Motto6666/Material_Sorting_Pipeline/README.md

# Material_Sorting_Pipeline
Material_Sorting_Pipeline_Code
