Motto6666/Material_Sorting_Pipeline/Program_Flow Chart/OpenMv模块程序流程图.jpg

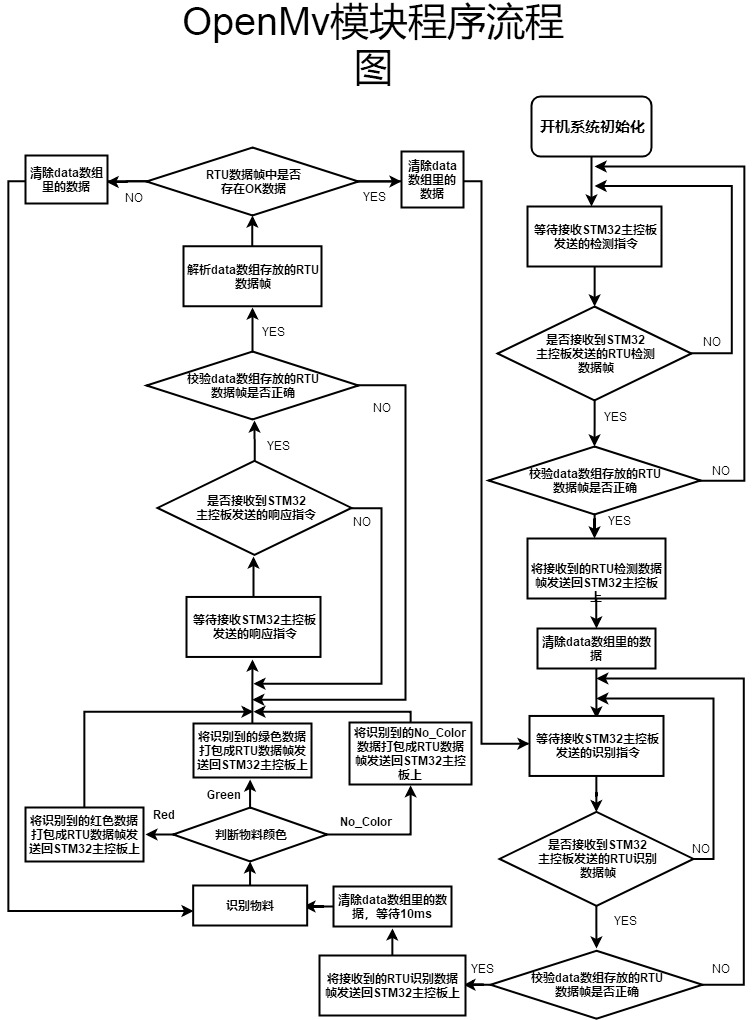
Program_Flow Chart/OpenMv模块程序流程图.jpg
