Motto6666/Material_Sorting_Pipeline/Program_Flow Chart/STM32F103机械手控制板程序流程图.jpg

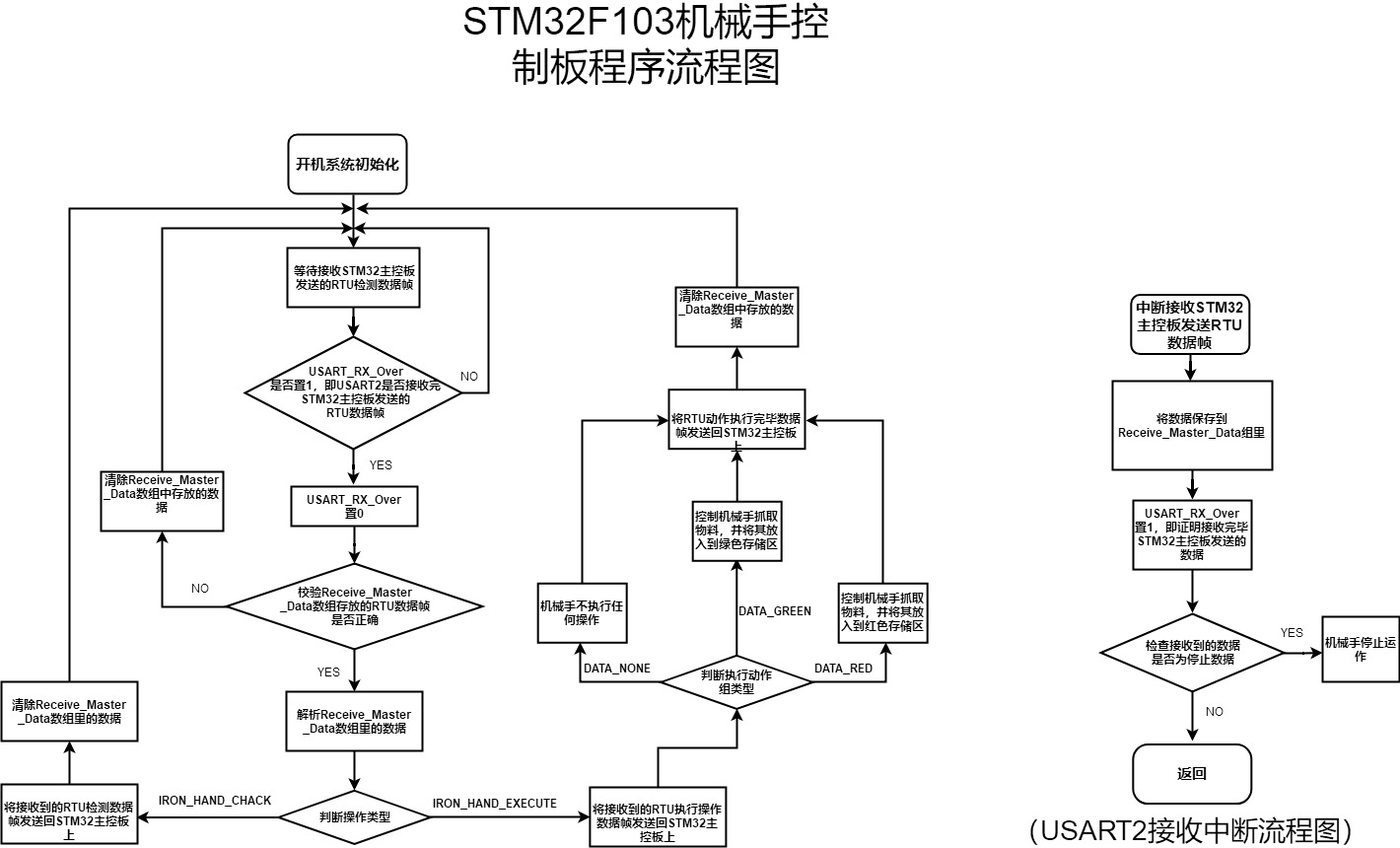
Program_Flow Chart/STM32F103机械手控制板程序流程图.jpg
