Motto6666/Material_Sorting_Pipeline/Program_Flow Chart/物料分拣流水线STM32F103主控板程序流程图.jpg

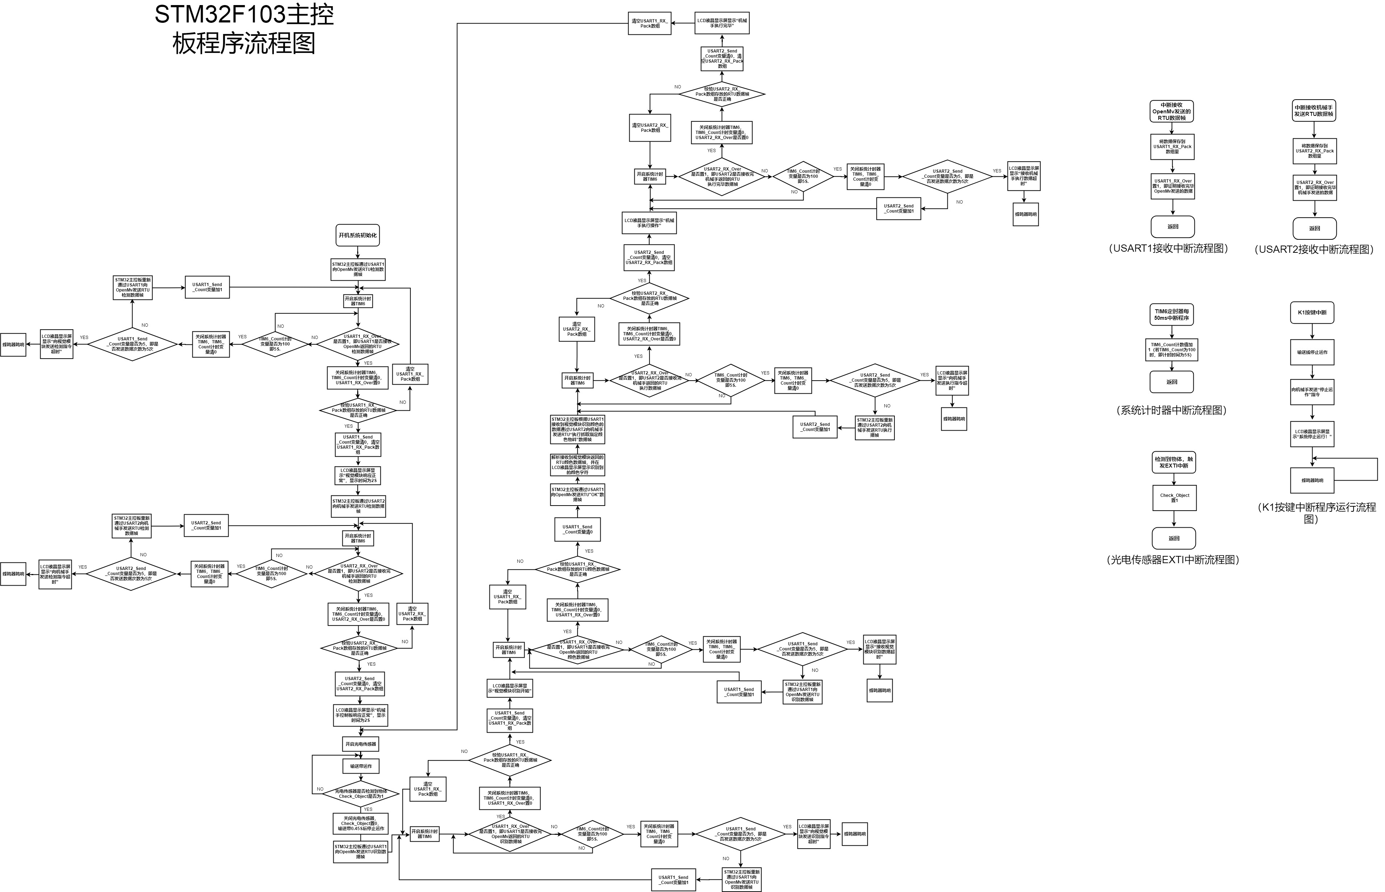
Program_Flow Chart/物料分拣流水线STM32F103主控板程序流程图.jpg
