Motto6666/Material_Sorting_Pipeline/Machine_Hand_Control_Code/USER/servo_control/servo_control.c

#include "servo_control.h"

Servo_Struct  Servo[SERVO_NUM];

/**
	* @brief  舵机脉冲宽度值初始化 
	* @retval 无
	*/
void Servo_Pulse_Width_Init(void)
{
	uint8_t i;
	for(i=1;i<=SERVO_NUM;i++)
	{
		Servo[i].Current_PWM = 1500;
		Servo[i].Increment_PWM = 0;
  }
}


/**
	* @brief  舵机I/O引脚电平控制 
	* @retval 无
	*/
void Servo_IO_Set(uint8_t Index, uint8_t Level) 
{
	switch(Index) 
	{
		case 1:Servo_Pin_Set(SERVO_PORT_2, SERVO_1_PIN, Level);break;
		case 2:Servo_Pin_Set(SERVO_PORT_1, SERVO_2_PIN, Level);break;
		case 3:Servo_Pin_Set(SERVO_PORT_2, SERVO_3_PIN, Level);break;
		case 4:Servo_Pin_Set(SERVO_PORT_2, SERVO_4_PIN, Level);break;
		case 5:Servo_Pin_Set(SERVO_PORT_2, SERVO_5_PIN, Level);break;
		default:break;
	}
}



/**
	* @brief  舵机引脚电平控制 
	* @retval 无
	*/
void Servo_Pin_Set(GPIO_TypeDef* GPIOx, uint16_t Pin, uint8_t Level) 
{
	if(Level) 
	{
		GPIO_SetBits(GPIOx,Pin);
	} 
	else 
	{
		GPIO_ResetBits(GPIOx,Pin);
	}
}


/**
	* @brief  舵机脉冲宽度控制，运用定时器控制舵机引脚高低电平的时间，
						让舵机引脚产生具有脉冲宽度的方波，达到控制舵机转动的目的
	* @retval 无
	*/
extern volatile uint8_t Flag;
volatile uint8_t Servo_Num = 1;
void Servo_Pulse_Width_Control(void)
{
	if(Servo_Num == 6) 
		{
			Servo_Num = 1;
		}
		
		if(!Flag) 
		{
			Servo_Pulse_Width_Increment_Apply(Servo_Num);
			TIM2_INTERRUPT_TIME = ( (uint32_t)Servo[Servo_Num].Current_PWM );//设定TIM2定时中断时间，单位为us
			Servo_IO_Set(Servo_Num, HIGH);//保持TIM2_INTERRUPT_TIME高电平时间
		}
		else 
	  {
			TIM2_INTERRUPT_TIME = 2500 - ((uint32_t)Servo[Servo_Num].Current_PWM);//设定TIM2定时中断时间，单位为us
			Servo_IO_Set(Servo_Num, LOW);//保持TIM2_INTERRUPT_TIME低电平时间
			Servo_Num ++;
		}
}


/**
	* @brief  舵机脉冲宽度增量值的运用，让舵机在单位时间内转动一定的
						角度，达到控制舵机转动速度的目的 
	* @retval 无
	*/
void Servo_Pulse_Width_Increment_Apply(uint8_t Servo_Num) 
{	
	if(Servo[Servo_Num].Increment_PWM != 0) 
	{
		if(Abs_Float( Servo[Servo_Num].Aim_PWM - Servo[Servo_Num].Current_PWM) <= Abs_Float( 2*Servo[Servo_Num].Increment_PWM ))          
		{
			Servo[Servo_Num].Current_PWM   =  Servo[Servo_Num].Aim_PWM;
			Servo[Servo_Num].Increment_PWM =  0;
		} 
		else 
		{
			Servo[Servo_Num].Current_PWM += Servo[Servo_Num].Increment_PWM;
		}
	}
}


/**
	* @brief  取绝对值
	* @retval 无
	*/
float Abs_Float(float Value) 
{
	if(Value>0) 
	{
		return Value;
	}
	return (-Value);
}
