Motto6666/Material_Sorting_Pipeline/Machine_Hand_Control_Code/USER/servo_control/servo_control.h

#ifndef __SERVO_CONTROL_H
#define __SERVO_CONTROL_H

#include "stm32f10x.h"
#include "bsp_servo_gpio.h"

#define SERVO_NUM               5
#define HIGH                    1
#define LOW                     0
#define TIM2_INTERRUPT_TIME     TIM2->ARR

typedef struct 
{
	uint16_t 	Aim_PWM;	      //脉冲宽度目标值
 	uint16_t 	Time;	          //执行时间		
	float 		Current_PWM;	  //当前脉冲宽度
	float 		Increment_PWM;	//脉冲宽度增量	
}Servo_Struct;

void Servo_Pulse_Width_Init(void);
void Servo_IO_Set(uint8_t Index, uint8_t Level) ; 
void Servo_Pin_Set(GPIO_TypeDef* GPIOx, uint16_t Pin, uint8_t Level);
void Servo_Pulse_Width_Control(void); 
void Servo_Pulse_Width_Increment_Apply(uint8_t Servo_Num);
float Abs_Float(float Value); 


#endif /*SERVO_CONTROL_H*/
