Motto6666/Material_Sorting_Pipeline/Material_Sorting_Pipeline_Master_Code/BSP/lcd/bsp_ili9341_lcd.h

#ifndef __BSP_ILI9341_LCD_H
#define __BSP_ILI9341_LCD_H

#include "stm32f10x.h"
#include <stdio.h>


//CS(NSS)引脚 片选选普通GPIO即可
#define      ILI9341_CS_CLK                  RCC_APB2Periph_GPIOC   
#define      ILI9341_CS_PORT                 GPIOC
#define      ILI9341_CS_PIN                  GPIO_Pin_4

//RD引脚 片选选普通GPIO即可
#define      ILI9341_RD_CLK                  RCC_APB2Periph_GPIOC   
#define      ILI9341_RD_PORT                 GPIOC
#define      ILI9341_RD_PIN                  GPIO_Pin_5

//WE引脚 片选选普通GPIO即可
#define      ILI9341_WE_CLK                  RCC_APB2Periph_GPIOC   
#define      ILI9341_WE_PORT                 GPIOC
#define      ILI9341_WE_PIN                  GPIO_Pin_6

//DC引脚 片选选普通GPIO即可
#define      ILI9341_DC_CLK                  RCC_APB2Periph_GPIOC   
#define      ILI9341_DC_PORT                 GPIOC
#define      ILI9341_DC_PIN                  GPIO_Pin_7

//BK引脚 片选选普通GPIO即可
#define      ILI9341_BK_CLK                  RCC_APB2Periph_GPIOD  
#define      ILI9341_BK_PORT                 GPIOD
#define      ILI9341_BK_PIN                  GPIO_Pin_2

//D0-D15引脚 片选选普通GPIO即可
#define      ILI9341_DATA_CLK                  RCC_APB2Periph_GPIOB   
#define      ILI9341_DATA_PORT                 GPIOB
#define      ILI9341_DATA_PIN                  GPIO_Pin_All//定义了PB端口的全部引脚（PB0~PB15）

#define  		LCD_BK_ON()     						GPIO_ResetBits( ILI9341_BK_PORT, ILI9341_BK_PIN )
#define  		LCD_BK_OFF()    						GPIO_SetBits( ILI9341_BK_PORT, ILI9341_BK_PIN )

#define  		LCD_CS_HIGH()     					GPIO_SetBits( ILI9341_CS_PORT, ILI9341_CS_PIN )
#define  		LCD_CS_LOW()    						GPIO_ResetBits( ILI9341_CS_PORT, ILI9341_CS_PIN )

#define  		LCD_DC_HIGH()     					GPIO_SetBits( ILI9341_DC_PORT, ILI9341_DC_PIN )
#define  		LCD_DC_LOW()    						GPIO_ResetBits( ILI9341_DC_PORT, ILI9341_DC_PIN )

#define  		LCD_WE_HIGH()     					GPIO_SetBits( ILI9341_WE_PORT, ILI9341_WE_PIN )
#define  		LCD_WE_LOW()    						GPIO_ResetBits( ILI9341_WE_PORT, ILI9341_WE_PIN )

#define  		LCD_RD_HIGH()     					GPIO_SetBits( ILI9341_RD_PORT, ILI9341_RD_PIN )
#define  		LCD_RD_LOW()    						GPIO_ResetBits( ILI9341_RD_PORT, ILI9341_RD_PIN )

#define  		LCD_DATA_OUT(data)     			ILI9341_DATA_PORT->ODR = data //GPIO_Write(ILI9341_DATA_PORT,data),直接操作寄存器，可以参考该编程!!
#define  		LCD_DATA_IN()     					GPIO_ReadInputData(ILI9341_DATA_PORT)

/*初始化delay*/
#define      DEBUG_DELAY()       ILI9341_Delay(0xFFFF)       

/******************************* 定义 ILI934 常用命令 ********************************/
#define      CMD_SetCoordinateX		 		    0x2A	     //设置X坐标
#define      CMD_SetCoordinateY		 		    0x2B	     //设置Y坐标
#define      CMD_SetPixel		 		          0x2C	     //填充像素


#define 			ILI9341_LESS_PIXEL	  							240			//液晶屏较短方向的像素宽度
#define 			ILI9341_MORE_PIXEL	 								320			//液晶屏较长方向的像素宽度

/******************************* 定义 ILI934 显示屏常用颜色 ********************************/
#define      BACKGROUND		                BLACK   //默认背景颜色

#define      WHITE		 		                  0xFFFF	   //白色
#define      BLACK                         0x0000	   //黑色 
#define      GREY                          0xF7DE	   //灰色 
#define      BLUE                          0x001F	   //蓝色 
#define      BLUE2                         0x051F	   //浅蓝色 
#define      RED                           0xF800	   //红色 
#define      MAGENTA                       0xF81F	   //红紫色，洋红色 
#define      GREEN                         0x07E0	   //绿色 
#define      CYAN                          0x7FFF	   //蓝绿色，青色 
#define      YELLOW                        0xFFE0	   //黄色 
#define      BRED                          0xF81F
#define      GRED                          0xFFE0
#define      GBLUE                         0x07FF

/*ILIL9341接口定义-结尾****************************/
void ILI9341_GPIO_Init(void);
uint16_t ILI9341_Read_ID(void);
void LCD_Init(void);
void ILI9341_GramScan ( uint8_t ucOption );
void ILI9341_Open_Window(uint16_t x,uint16_t y,uint16_t width, uint16_t heigh);
void ILI9341_Draw_Rect(uint16_t x,uint16_t y,uint16_t width, uint16_t heigh,uint16_t color);
void ILI9341_Draw_Point(uint16_t x,uint16_t y,uint16_t color);

#endif /* __BSP_ILI9341_LCD_H */
