Motto6666/Material_Sorting_Pipeline/Machine_Hand_Control_Code/BSP/usart1/bsp_usart1.h

#ifndef __BSP_USART1_H
#define	__BSP_USART1_H


#include "stm32f10x.h"
#include "bsp_systick.h"

/** 
  * 串口宏定义，不同的串口挂载的总线和IO不一样，移植时需要修改这几个宏
	* 1-修改总线时钟的宏，uart1挂载到apb2总线，其他uart挂载到apb1总线
	* 2-修改GPIO的宏
  */


/*串口1-USART1*/
#define  DEBUG_USART1                   USART1
#define  DEBUG_USART1_CLK               RCC_APB2Periph_USART1
#define  DEBUG_USART1_APBxClkCmd        RCC_APB2PeriphClockCmd
#define  DEBUG_USART1_BAUDRATE          115200

/*USART GPIO 引脚宏定义*/
#define  DEBUG_USART1_GPIO_CLK           (RCC_APB2Periph_GPIOA)
#define  DEBUG_USART1_GPIO_APBxClkCmd    RCC_APB2PeriphClockCmd
    
#define  DEBUG_USART1_TX_GPIO_PORT       GPIOA   
#define  DEBUG_USART1_TX_GPIO_PIN        GPIO_Pin_9
#define  DEBUG_USART1_RX_GPIO_PORT       GPIOA
#define  DEBUG_USART1_RX_GPIO_PIN        GPIO_Pin_10

#define  DEBUG_USART1_IRQ                USART1_IRQn
#define  DEBUG_USART1_IRQHandler         USART1_IRQHandler

void USART1_Config(void);
void USART1_Printf(uint8_t *String);

#endif /* __BSP_USART1_H */
