Motto6666/Material_Sorting_Pipeline/Material_Sorting_Pipeline_Master_Code/BSP/key/bsp_exti_key.c

#include "bsp_exti_key.h"

static void Key1_NVIC_Config(void)
{
	NVIC_InitTypeDef NVIC_InitStruct;
	
	/*第一步：配置中断优先级的分组*/
	NVIC_PriorityGroupConfig(NVIC_PriorityGroup_0);
	
	/*第二步：配置NVIC初始化结构体*/
	NVIC_InitStruct.NVIC_IRQChannel = KEY1_EXTI_IRQn;
	NVIC_InitStruct.NVIC_IRQChannelPreemptionPriority = 0;
	NVIC_InitStruct.NVIC_IRQChannelSubPriority = 0;
	NVIC_InitStruct.NVIC_IRQChannelCmd = ENABLE;
	
	/*第三步：调用NVIC初始化函数把配置好的结构体写到寄存器里*/
	NVIC_Init(&NVIC_InitStruct);
}

void Key1_EXTI_Config(void)
{ 
	GPIO_InitTypeDef GPIO_InitStruct;
  EXTI_InitTypeDef EXTI_InitStruct;		
	
	/*初始化KEY1端口时钟*/
	RCC_APB2PeriphClockCmd(KEY1_GPIO_PORT_Clock,ENABLE);
	/*初始化KEY1引脚*/
	GPIO_InitStruct.GPIO_Pin = KEY1_PIN;
	GPIO_InitStruct.GPIO_Mode = GPIO_Mode_IN_FLOATING;
	/*初始化KEY1端口*/
	GPIO_Init(KEY1_GPIO_PORT, &GPIO_InitStruct);
	

	/*初始化复用功能的AFIO配置*/
	RCC_APB2PeriphClockCmd(RCC_APB2Periph_AFIO,ENABLE);
	/*将PAO连接到EXTI中*/
	GPIO_EXTILineConfig(KEY1_EXTI_GPIO_PortSource,KEY1_EXTI_GPIO_PinSource);
	
	/*初始化EXTI外设结构体*/
	EXTI_InitStruct.EXTI_Line     = KEY1_EXTI_LINE;
	EXTI_InitStruct.EXTI_Mode     = EXTI_Mode_Interrupt;
	EXTI_InitStruct.EXTI_Trigger  = EXTI_Trigger_Rising;
	EXTI_InitStruct.EXTI_LineCmd  = ENABLE;
	
	/*调用EXTI初始化函数，将EXTI初始化结构体写入寄存器里*/
	EXTI_Init(&EXTI_InitStruct);
	
}


/**
  * @brief  初始化Key1按键
  * @retval 无
  */
void Key_Init(void)
{
	Key1_NVIC_Config();
	Key1_EXTI_Config();
}


 /**
  * @brief  停止系统运行，如当按键按下后，输送带和机械手停止运作
  * @retval 无
  */
uint8_t Data_Stirng2[1];
void System_Stop(void)
{
	MOTOR_STOP;
	Send_RTU_Data(IRON_HAND_ADD, IRON_HAND_EXECUTE_STOP, 0, Data_Stirng2, USART2_DEVICE);
	Clean_Screen(7);//清除第七行里面的字符
	Display_Chinese_String( Chinese_Character_18  ,7  ,7 ,1 ,RED);//显示“系统停止运行！”
	Display_Rectangle();
}




 /**
  * @brief  KEY1_EXTI中断服务函数
  * @retval 无
  */
void KEY1_EXTI_IRQHandler(void)
{
  if(EXTI_GetITStatus(KEY1_EXTI_LINE) != RESET)
	{
		EXTI_ClearITPendingBit(KEY1_EXTI_LINE);
		System_Stop();
	}
}
