Motto6666/Material_Sorting_Pipeline/Machine_Hand_Control_Code/BSP/usart2/bsp_usart2.h

#ifndef __BSP_USART2_H
#define	__BSP_USART2_H


#include "stm32f10x.h"
#include "bsp_systick.h"
#include "modbus_agreement.h"
#include "bsp_tim2.h"

// 串口2-USART2
#define  DEBUG_USART2                    USART2
#define  DEBUG_USART2_CLK                RCC_APB1Periph_USART2
#define  DEBUG_USART2_APBxClkCmd         RCC_APB1PeriphClockCmd
#define  DEBUG_USART2_BAUDRATE           115200

// USART GPIO 引脚宏定义
#define  DEBUG_USART2_GPIO_CLK           (RCC_APB2Periph_GPIOA)
#define  DEBUG_USART2_GPIO_APBxClkCmd    RCC_APB2PeriphClockCmd
    
#define  DEBUG_USART2_TX_GPIO_PORT       GPIOA   
#define  DEBUG_USART2_TX_GPIO_PIN        GPIO_Pin_2
#define  DEBUG_USART2_RX_GPIO_PORT       GPIOA
#define  DEBUG_USART2_RX_GPIO_PIN        GPIO_Pin_3

#define  DEBUG_USART2_IRQ                USART2_IRQn
#define  DEBUG_USART2_IRQHandler         USART2_IRQHandler

#define  TURE														 1		
#define  FALSE													 0

extern uint8_t Receive_Master_Data[10];
extern volatile uint8_t USART_RX_Over;

void USART2_Config(void);
void Send_Data_to_Master(uint8_t *Str);
void Clean_Data(uint8_t *Str);
void Check_Stop_Data(uint8_t *Str);

#endif /* __BSP_USART2_H */
