Motto6666/Material_Sorting_Pipeline/Material_Sorting_Pipeline_Master_Code/BSP/key/bsp_exti_key.h

#ifndef __BSP_EXTI_KEY_H
#define __BSP_EXTI_KEY_H

#include "stm32f10x.h"
#include "system_init.h"
#include "modbus_agreement.h"

#define KEY1_GPIO_PORT_Clock        RCC_APB2Periph_GPIOA
#define KEY1_GPIO_PORT              GPIOA
#define KEY1_PIN                    GPIO_Pin_0
#define KEY1_EXTI_GPIO_PortSource   GPIO_PortSourceGPIOA
#define KEY1_EXTI_GPIO_PinSource    GPIO_PinSource0
#define KEY1_EXTI_LINE              EXTI_Line0
#define KEY1_EXTI_IRQn              EXTI0_IRQn
#define KEY1_EXTI_IRQHandler        EXTI0_IRQHandler

void Key_Init(void);
void System_Stop(void);

#endif /*__BSP_EXTI_KEY_H*/
