Motto6666/Material_Sorting_Pipeline/Machine_Vision_Code/receive_data.py

from pyb import UART
uart3 = UART(3,115200) #设置通信串口P4、P5
ok = 0x04

def data_receive(add,function):
    if( uart3.any() ):
        data = uart3.read()
        if( (data[0] == add and data[1] == function)  or  data[3] == ok ):
            return data
    return 0


def data_send(data):
     uart3.write( data)
