Motto6666/Material_Sorting_Pipeline/(commit log)

2019-04-04 LCD液晶显示程序，已有项目所需的显示功能
2019-04-04 删除了串口打印字模
2019-04-04 舵机机械手控制程序，已完成六路舵机的控制
2019-04-07 实现了解析动作组，执行单个动作的功能
2019-04-09 修改了舵机结构体中的名称，修改了部分程序中的注释
2019-04-09 实现多个动作组的执行，完成项目所需的动作
2019-04-10 机器视觉完成识别红色与绿色的物体
2019-04-13 已完成Modbus协议RTU模式数据帧的打包和发送
2019-04-14 完成RTU数据帧的接收和解析，使用TIM7实现中断接收超时检测（即可以判断USART1串口数据是否接收完毕），实现与OpenMV通信超时处理
2019-04-16 RTU数据帧更改为16进制数，完成USART1与USART2RTU数据帧得发送和接收，实现了主控板与openMV模块通信
2019-04-17 完善openMV模块数据接收即发送程序，目前openMV发送RTU数据帧仍存在问题
2019-04-18 解决了openMV发送16进制的RTU数据帧，完善stm32主控板的接收RTU数据程序，添加了解析RTU数据帧的函数，暂未测试
2019-04-19 STM32数据帧校验程序测试成功，完成STM32主控板与openMV完整的通信程序（模块宕机处理，数据传输异常处理，通信超时处理）
2019-04-20 修复了主控板与openMV的隐藏的bug，完善了STM32主控板代码的编写格式，修改了openMV接收数据帧的编程逻辑
2019-04-21 STM32主控板添加了接收机械手控制板数据程序以及相关LCD液晶显示的文字（未测试），机械手控制板添加了USART2，TIM3外设程序（未初始化，未测试）
2019-04-23 STM32主控板与机械手模块通信测试成功，通信正常，机械手执行不了动作组，仍需检查bug
2019-04-23 完成STM32主控板、OpenMV模块以及机械手模块这三者通信（测试成功，达到作品所需的功能要求，并通过了10钟运行测试）
2019-04-24 修改了STM32主控板、openMV程序中部分函数名称，删除不必要的注释
2019-04-24 完善Openmv接收STM32识别成功数据帧程序，完善STM32发送ok数据帧到Openmv程序
2019-04-24 添加了驱动电机程序，测试出问题，烧录程序后第一次开机时，电机运作正常，关机再次启动单片机，电机不运转
2019-04-25 修改了bsp_motor_control.c\.h文件程序
2019-04-25 利用TIM2控制PA6引脚高低电平变化，模拟固件库程序的PWM输出，提高程序移植性，电机能够正常运作
2019-04-25 完善bsp_motor_control.c/.h程序中的函数名称，变量名称
2019-04-26 添加了光电传感器程序，实现了在机器视觉范围内检测物体，初步完成了作品所需得全部功能，不过仍然存在bug，bug在于机器视觉两次重复检测物体
2019-04-26 修复了机器视觉两次重复检测的问题（问题在于没有控制好EXTI外设的开启和关闭），添加了EXTI外设的开启、关闭函数，不过仍存在bug，bug在于上升沿和下降沿都能触发EXTI中断（EXTI外设配置为下降沿触发）
2019-04-27 解决了外部中断触发问题，修改了机械手动作组
2019-04-29 在机械手控制程序上添加了串口空闲中断程序（未测试）
2019-04-29 机械手串口空闲中断程序测试成功，删除TIM3定时器程序（前期用于超时检测，检测数据是否接收完毕）
2019-04-29 在STM32主控板程序中添加了USART11串口空闲中断函数，并测试成功
2019-04-29 在STM32主控板上添加了USART2串口空闲中断程序，并测试成功，删除了TIM7定时器程序（前期用于超时检测，检测数据是否接收完毕）
2019-04-29 修改了STM32主控板USART1、USART2串口存放接收数据的数组，减小了数组元素的个数
2019-04-29 在STM32主控板添加了K1按键中断系统运行程序，机械手控制板添加接收到停止命令停止动作组的运作程序，程序测试成功，达到要求的功能
2019-04-30 在STM32主控板中添加了蜂鸣器程序，测试成功，起到了超时警示或停止系统运行警示作用
2019-04-30 在机械手控制程序中删除了TIM3外设配置程序
2019-04-30 删除了LC无用LCD_Display_Code程序
2019-04-30 完善了STM32主控板、机械手控制模块的部分中文注释
2019-04-30 修改了STM32主控板中的显示字符的字模数据
2019-04-30 删除无用的LCD液晶显示事例程序
2019-05-01 修改了STM32主控板，机械手模块程序中多余的功能语句
2019-05-02 物料分拣流水线作品完成了25分钟连续测试，均无出现问题
2019-05-03 在STM32主控板程序中添加了部分注释
2019-05-03 添加了程序流程图以及技术文档
2019-05-07 优化STM32主控板中main.c文件程序（修改了当识别到不是规定颜色的物体时所执行的程序逻辑），在机械手executete_action_group.c程序中删除了接收DATA_NONE数据程序。测试成功
2019-05-08 减少机械手执行动作组时间，提高机械手抓取物料的效率，测试成功
2019-05-08 修改了光电传感器的触发引脚（修改为PC2引脚），测试成功
